StevenFAU/IoT_Terrarium/terrarium_cam/wifi_secrets.example.h

// Copy this file to wifi_secrets.h (same folder) and set your own password, 8-63 characters.
// wifi_secrets.h is git-ignored so the real password never ends up in the repo.
#define WIFI_AP_NAME     "Terrarium-Cam"
#define WIFI_AP_PASSWORD "change-me-please"
