StevenFAU/IoT_Terrarium/(commit log)

2026-11-06 Import terrarium sketches and photo-saving tool
    Heltec WiFi LoRa 32 (V2) sender and receiver, ESP32-CAM camera sketch,
    board self-test and save_images.py, as built and tested on the bench.
    WiFi passwords are kept out of git; see wifi_secrets.example.h.
2026-11-06 Add interactive dashboard served by the receiver board
    The receiver now hosts a full mobile/desktop dashboard on its own WiFi
    network: live readings with target-range status and alerts, 1/6/24 h
    history charts with a synced cursor and CSV export, a photo gallery
    with timestamps and a viewer, and settings saved on the board.
    Receiver firmware 2.0 keeps one averaged sample per minute for 24 h,
    dates photos (clock set by the viewer's device), stores settings in
    flash, and serves the dashboard plus a JSON API, also reachable over
    USB serial for testing.
    The dashboard is plain HTML/CSS/JS with no libraries, since phones on
    the board's network have no internet. tools/build_dashboard.py gzips it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
